MicrochipTech/EERAM-Curiosity-Demo/Docs/Media/EERAM-Curiosity-Demo.jpg

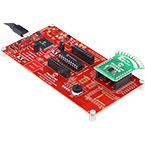
Docs/Media/EERAM-Curiosity-Demo.jpg
