MicrochipTech/EERAM-Curiosity-Demo/Docs/EERAM Curiosity Demo Bill of Materials.xls

Sheet: BOM Report
Bill of Materials |  | EERAM DEMO FOR FIELD APPS
Document Number: | 02-EERAM_DEMO_FAE_1.00 |  |  |  |  | M
Board Number: | 04-EERAM_DEMO_FAE_1.00
Part Number: | 47L64
Revision: | 1.00
Engineer: | Dragos Ciofu
Drawn By: | Dragos Ciofu
Creation Date: | 7:39:08 PM
Print Date: | 19:40:01
Quantity | Designator | Description_ | Manufacturer 1 | Manufacturer Part Number 1 | Supplier 1 | Supplier Part Number 1 | Supplier Unit Price 1 | Price / 1 Board | Populated | Quantity | Quantity Override | Status | MCHP-ID
1 | C1 | CAP CER 22uF 10V 20% X5R SMD 1206 | Taiyo Yuden (https://octopart-clicks.com/click/altium?sku=587-1343-1-ND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) | LMK316BJ226ML-T (https://octopart-clicks.com/click/altium?sku=587-1343-1-ND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) | Digi-Key | 587-1343-1-ND (https://octopart-clicks.com/click/altium?sku=587-1343-1-ND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) |  | $0.0000 | Yes | 1 | 1 | MCL Design | CAP0563
1 | C3 | CAP CER 0.1uF 16V 10% X7R SMD 0603 | AVX (https://octopart-clicks.com/click/altium?sku=478-1239-1-ND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) | 0603YC104KAT2A (https://octopart-clicks.com/click/altium?sku=478-1239-1-ND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) | Digi-Key | 478-1239-1-ND (https://octopart-clicks.com/click/altium?sku=478-1239-1-ND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) |  | $0.0000 | YES | 1 | 1 | Production | CAP0011
1 | C4 | CAP CER 4.7uF 10V 80% Y5V SMD 0603 | Murata (https://octopart-clicks.com/click/altium?sku=490-3302-1-ND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) | GRM188F51A475ZE20D (https://octopart-clicks.com/click/altium?sku=490-3302-1-ND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) | Digi-Key | 490-3302-1-ND (https://octopart-clicks.com/click/altium?sku=490-3302-1-ND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) |  | $0.0000 | YES | 1 | 1 | Production | CAP0384
2 | JM1, JM2 | CON HDR-2.54 Male 1x8 Gold 5.84MH TH | FCI (https://octopart-clicks.com/click/altium?sku=609-3273-ND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) | 68001-108HLF (https://octopart-clicks.com/click/altium?sku=609-3273-ND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) | Digi-Key | 609-3273-ND (https://octopart-clicks.com/click/altium?sku=609-3273-ND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) |  | $0.0000 | YES | 2 | 1 | Production | CON1302
1 | LABEL1 | LABEL, NEED HELP WITH ASSY/SERIAL |  |  |  |  |  | $0.0000 | MECH | 1 | 1 | MCL Design | 08-00126
1 | LABEL2 | LABEL, ASSY W/REV LEVEL (SMALL MODULES) PER MTS-0002 |  |  |  |  |  | $0.0000 | MECH | 1 | 1 | MCL Design | 08-00028
1 | LABEL3 | Label, AIPD Board Assembly |  |  |  |  |  | $0.0000 | MECH | 1 | 1 | MCL Design | 08-00004
13 | LD0, LD1, LD2, LD3, LD4, LD5, LD6, LD7, LD8, LD9, LD10, LD11, LP | DIO LED GREEN 2V 30mA 44.5mcd Clear SMD 1206 | Lite-On Inc (https://octopart-clicks.com/click/altium?sku=160-1404-1-ND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) | LTST-C150KGKT (https://octopart-clicks.com/click/altium?sku=160-1404-1-ND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) | Digi-Key | 160-1404-1-ND (https://octopart-clicks.com/click/altium?sku=160-1404-1-ND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) |  | $0.0000 | YES | 13 | 1 | MCL Design | DIODE1020
1 | LR | DIO LED RED 1.7V 20mA 51mcd Clear SMD 1206 | Visual Communications Company (https://octopart-clicks.com/click/altium?manufacturer=Visual%20Communications%20Company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) | CMD11-21SRC/TR8 (https://octopart-clicks.com/click/altium?manufacturer=Visual%20Communications%20Company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) | Digi-Key | L62011CT-ND (https://octopart-clicks.com/click/altium?manufacturer=Visual%20Communications%20Company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) |  | $0.0000 | Yes | 1 | 1 | MCL Design | LED0094
7 | R1, RL0, RL1, RL2, RL3, RLP, RLR | RES TKF 82R 1% 1/4W SMD 0603 | Vishay (https://octopart-clicks.com/click/altium?sku=CRCW060382R0FKEAHP-ND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) | CRCW060382R0FKEAHP (https://octopart-clicks.com/click/altium?sku=CRCW060382R0FKEAHP-ND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) | Digi-Key | CRCW060382R0FKEAHP-ND (https://octopart-clicks.com/click/altium?sku=CRCW060382R0FKEAHP-ND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) |  | $0.0000 | Yes | 7 | 1 | Production | RES1211
2 | RP1, RP2 | RES TKF 2k 1% 1/10W SMD 0603 | Panasonic (https://octopart-clicks.com/click/altium?sku=P2.00KHTR-ND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) | ERJ-3EKF2001V (https://octopart-clicks.com/click/altium?sku=P2.00KHTR-ND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) | Digi-Key | P2.00KHTR-ND (https://octopart-clicks.com/click/altium?sku=P2.00KHTR-ND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) |  | $0.0000 | YES | 2 | 1 | Production | RSMT0382
1 | U1 |  |  |  |  |  |  | $0.0000 |  | 1
Microchip Parts listed below
 |  |  |  |  |  |  |  | $0.0000
 |  |  |  |  |  |  |  | $0.0000
 |  |  |  |  |  |  |  | $0.0000
 |  |  |  |  |  |  |  | $0.0000
Mechanical Parts to be added in the package
 |  |  |  |  |  |  |  | $0.0000
PCB
1 | PCB1 | Printed Circuit Board |  | 04-EERAM_DEMO_FAE_1.00-R1.00 |  |  |  | $0.0000 | PCB | 1 | 1 |  | 04-EERAM_DEMO_FAE_1.00
 |  |  |  |  |  |  |  | $0.0000
Do Not Populate Parts listed below
 |  |  |  |  |  |  |  | $0.0000
Approved | Notes | Description

Sheet: Project Information
Project Full Path | C:\ALTIUM_WORK\Projects\I2C DEMO ALTIUM 18\I2C DEMO ALTIUM 18.PrjPcb
Project Filename | I2C DEMO ALTIUM 18.PrjPcb
Variant Name | None
Board Number | EERAM_DEMO_FAE_1.00
Data-Source Filename | I2C DEMO ALTIUM 18.PrjPcb
Data-Source Full Path | C:\ALTIUM_WORK\Projects\I2C DEMO ALTIUM 18\I2C DEMO ALTIUM 18.PrjPcb
Title | EERAM DEMO FOR FIELD APPS
Total Quantity | 32
Report Time | 7:39:08 PM
Report Date | 7/9/2018
Report Date & Tine | 7/9/2018 7:39:08 PM
Output Name | Bill of Materials
Output Type | BOM_PartType
Output Generator Name | BOM
Output Generator Description | Bill of Materials
PCB Label Number | <Parameter ProjectBoardLabel not found>
Part Number | 47L64
SCH Revision | 1.00
ART Revision | 1.00
ASM Revision | 1.00
FAB Revision | 1.00

Sheet: MCL Report
DesignItemId | Quantity | Designator | Populated | Fitted | Description_ | Value | Status | Library Name | PartType | Footprint | MCL Library Ref | MCL Footprint Ref | CurrentDate | Manufacturer 1 | Manufacturer 2 | Manufacturer 3 | Manufacturer 4 | Manufacturer 5 | Manufacturer 6 | Manufacturer 7 | #Column Name Error:Manufacturer 8 | #Column Name Error:Manufacturer 9 | #Column Name Error:Manufacturer 10 | Manufacturer Part Number 1 | Manufacturer Part Number 2 | Manufacturer Part Number 3 | Manufacturer Part Number 4 | Manufacturer Part Number 5 | Manufacturer Part Number 6 | Manufacturer Part Number 7 | #Column Name Error:Manufacturer Part Number 8 | #Column Name Error:Manufacturer Part Number 9 | #Column Name Error:Manufacturer Part Number 10 | Supplier 1 | Supplier 2 | Supplier 3 | Supplier 4 | Supplier 5 | Supplier 6 | Supplier 7 | #Column Name Error:Supplier 8 | #Column Name Error:Supplier 9 | #Column Name Error:Supplier 10 | Supplier Part Number 1 | Supplier Part Number 2 | Supplier Part Number 3 | Supplier Part Number 4 | Supplier Part Number 5 | Supplier Part Number 6 | Supplier Part Number 7 | #Column Name Error:Supplier Part Number 8 | #Column Name Error:Supplier Part Number 9 | #Column Name Error:Supplier Part Number 10 | Supplier Unit Price 1 | Supplier Unit Price 2 | Supplier Unit Price 3 | Supplier Unit Price 4 | Supplier Unit Price 5 | Supplier Unit Price 6
CAP0563 | 1 | C1 | Yes | Fitted | CAP CER 22uF 10V 20% X5R SMD 1206 | 22uF | MCL Design | MCHP-CDB.DbLib | Capacitor NP | CAP_C_1206 |  |  | 7/9/2018 | Taiyo Yuden (https://octopart-clicks.com/click/altium?sku=587-1343-1-ND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) |  |  |  |  |  |  |  |  |  | LMK316BJ226ML-T (https://octopart-clicks.com/click/altium?sku=587-1343-1-ND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) |  |  |  |  |  |  |  |  |  | Digi-Key |  |  |  |  |  |  |  |  |  | 587-1343-1-ND (https://octopart-clicks.com/click/altium?sku=587-1343-1-ND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)
CAP0011 | 1 | C3 | YES | Fitted | CAP CER 0.1uF 16V 10% X7R SMD 0603 | 0.1uF | Production | MCHP-CDB-Offline.DbLib | Capacitor NP | CAP_C_0603 |  |  | 7/9/2018 | AVX (https://octopart-clicks.com/click/altium?sku=478-1239-1-ND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) | Murata (https://octopart-clicks.com/click/altium?sku=490-1532-1-ND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) | Panasonic (https://octopart-clicks.com/click/altium?sku=PCC1762CT-ND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) | Taiyo Yuden (https://octopart-clicks.com/click/altium?sku=587-1240-2-ND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) | Yageo (https://octopart-clicks.com/click/altium?sku=86H5248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) | NIC Components (https://octopart-clicks.com/click/altium?manufacturer=NIC%20Components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) |  |  |  |  | 0603YC104KAT2A (https://octopart-clicks.com/click/altium?sku=478-1239-1-ND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) | GRM188R71C104KA01D (https://octopart-clicks.com/click/altium?sku=490-1532-1-ND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) | ECJ-1VB1C104K (https://octopart-clicks.com/click/altium?sku=PCC1762CT-ND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) | EMK107B7104KA-T (https://octopart-clicks.com/click/altium?sku=587-1240-2-ND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) | CC0603KRX7R7BB104 (https://octopart-clicks.com/click/altium?sku=86H5248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) | NMC0603X7R104K16TRPF (https://octopart-clicks.com/click/altium?manufacturer=NIC%20Components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) |  |  |  |  | Digi-Key | Digi-Key | Digi-Key | Digi-Key | Newark | Digi-Key | NIC Components |  |  |  | 478-1239-1-ND (https://octopart-clicks.com/click/altium?sku=478-1239-1-ND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) | 490-1532-1-ND (https://octopart-clicks.com/click/altium?sku=490-1532-1-ND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) | PCC1762CT-ND (https://octopart-clicks.com/click/altium?sku=PCC1762CT-ND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) | 587-1240-2-ND (https://octopart-clicks.com/click/altium?sku=587-1240-2-ND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) | 86H5248 (https://octopart-clicks.com/click/altium?sku=86H5248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) | 311-1088-1-ND (https://octopart-clicks.com/click/altium?manufacturer=NIC%20Components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) | NMC0603X7R104K16TRPF
CAP0384 | 1 | C4 | YES | Fitted | CAP CER 4.7uF 10V 80% Y5V SMD 0603 | 4.7uF | Production | MCHP-CDB-Offline.DbLib | Capacitor NP | CAP_C_0603 |  |  | 7/9/2018 | Murata (https://octopart-clicks.com/click/altium?sku=490-3302-1-ND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) | Taiyo Yuden (https://octopart-clicks.com/click/altium?sku=587-1785-1-nd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) |  |  |  |  |  |  |  |  | GRM188F51A475ZE20D (https://octopart-clicks.com/click/altium?sku=490-3302-1-ND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) | JMK107BJ475KA-T (https://octopart-clicks.com/click/altium?sku=587-1785-1-nd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) |  |  |  |  |  |  |  |  | Digi-Key | Digi-Key |  |  |  |  |  |  |  |  | 490-3302-1-ND (https://octopart-clicks.com/click/altium?sku=490-3302-1-ND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) | 587-1785-1-nd (https://octopart-clicks.com/click/altium?sku=587-1785-1-nd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)
CON1302 | 2 | JM1, JM2 | YES | Fitted | CON HDR-2.54 Male 1x8 Gold 5.84MH TH | 2 x HDR-2.54 Male 1x8, [NoParam] | Production | MCHP-CDB-Offline.DbLib | Header 1x8 | HDR_M_2.54_1x8 |  |  | 7/9/2018 | FCI (https://octopart-clicks.com/click/altium?sku=609-3273-ND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) |  |  |  |  |  |  |  |  |  | 68001-108HLF (https://octopart-clicks.com/click/altium?sku=609-3273-ND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) |  |  |  |  |  |  |  |  |  | Digi-Key |  |  |  |  |  |  |  |  |  | 609-3273-ND (https://octopart-clicks.com/click/altium?sku=609-3273-ND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)
08-00126 | 1 | LABEL1 | MECH | Fitted | LABEL, NEED HELP WITH ASSY/SERIAL | Label Need Help Large | MCL Design | MCHP-CDB.DbLib | LABEL_Need_Help_Large | LABEL_Need_Help_Large |  |  | 7/9/2018
08-00028 | 1 | LABEL2 | MECH | Fitted | LABEL, ASSY W/REV LEVEL (SMALL MODULES) PER MTS-0002 | LABEL Need Help Small | MCL Design | MCHP-CDB.DbLib | LABEL_Need_Help_Small | LABEL_Need_Help_Small |  |  | 7/9/2018
08-00004 | 1 | LABEL3 | MECH | Fitted | Label, AIPD Board Assembly | LABEL Assy Very Small | MCL Design | MCHP-CDB.DbLib | LABEL_Assy_Very_Small | LABEL_Assy_Very_Small |  |  | 7/9/2018
DIODE1020 | 13 | LD0, LD1, LD2, LD3, LD4, LD5, LD6, LD7, LD8, LD9, LD10, LD11, LP | YES | Fitted | DIO LED GREEN 2V 30mA 44.5mcd Clear SMD 1206 | GREEN | MCL Design | MCHP-CDB.DbLib | LED_green | LED_1206_Green |  |  | 7/9/2018 | Lite-On Inc (https://octopart-clicks.com/click/altium?sku=160-1404-1-ND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) |  |  |  |  |  |  |  |  |  | LTST-C150KGKT (https://octopart-clicks.com/click/altium?sku=160-1404-1-ND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) |  |  |  |  |  |  |  |  |  | Digi-Key |  |  |  |  |  |  |  |  |  | 160-1404-1-ND (https://octopart-clicks.com/click/altium?sku=160-1404-1-ND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)
LED0094 | 1 | LR | Yes | Fitted | DIO LED RED 1.7V 20mA 51mcd Clear SMD 1206 | RED | MCL Design | MCHP-CDB.DbLib | LED_red | LED_1206_Red |  |  | 7/9/2018 | Visual Communications Company (https://octopart-clicks.com/click/altium?manufacturer=Visual%20Communications%20Company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) |  |  |  |  |  |  |  |  |  | CMD11-21SRC/TR8 (https://octopart-clicks.com/click/altium?manufacturer=Visual%20Communications%20Company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) |  |  |  |  |  |  |  |  |  | Digi-Key |  |  |  |  |  |  |  |  |  | L62011CT-ND (https://octopart-clicks.com/click/altium?manufacturer=Visual%20Communications%20Company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)
RES1211 | 7 | R1, RL0, RL1, RL2, RL3, RLP, RLR | Yes | Fitted | RES TKF 82R 1% 1/4W SMD 0603 | 82R, 100R | Production | MCHP-CDB-Offline.DbLib | Resistor | RES_C_0603 |  |  | 7/9/2018 | Vishay (https://octopart-clicks.com/click/altium?sku=CRCW060382R0FKEAHP-ND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) |  |  |  |  |  |  |  |  |  | CRCW060382R0FKEAHP (https://octopart-clicks.com/click/altium?sku=CRCW060382R0FKEAHP-ND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) |  |  |  |  |  |  |  |  |  | Digi-Key | Farnell |  |  |  |  |  |  |  |  | CRCW060382R0FKEAHP-ND (https://octopart-clicks.com/click/altium?sku=CRCW060382R0FKEAHP-ND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) | 1738890
RSMT0382 | 2 | RP1, RP2 | YES | Fitted | RES TKF 2k 1% 1/10W SMD 0603 | 2k | Production | MCHP-CDB-Offline.DbLib | Resistor | RES_C_0603 |  |  | 7/9/2018 | Panasonic (https://octopart-clicks.com/click/altium?sku=P2.00KHTR-ND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) |  |  |  |  |  |  |  |  |  | ERJ-3EKF2001V (https://octopart-clicks.com/click/altium?sku=P2.00KHTR-ND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) |  |  |  |  |  |  |  |  |  | Digi-Key | Digi-Key |  |  |  |  |  |  |  |  | P2.00KHTR-ND (https://octopart-clicks.com/click/altium?sku=P2.00KHTR-ND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) | P2.00KHCT-ND
eeram_spi | 1 | U1 |  | Fitted |  |  |  | eeram_i2c.SchLib | eeram_spi | SOIC-8 |  |  | 7/9/2018
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
