MicrochipTech/EERAM-Curiosity-Demo/Docs/EERAM Curiosity Demo Schematic.PDF

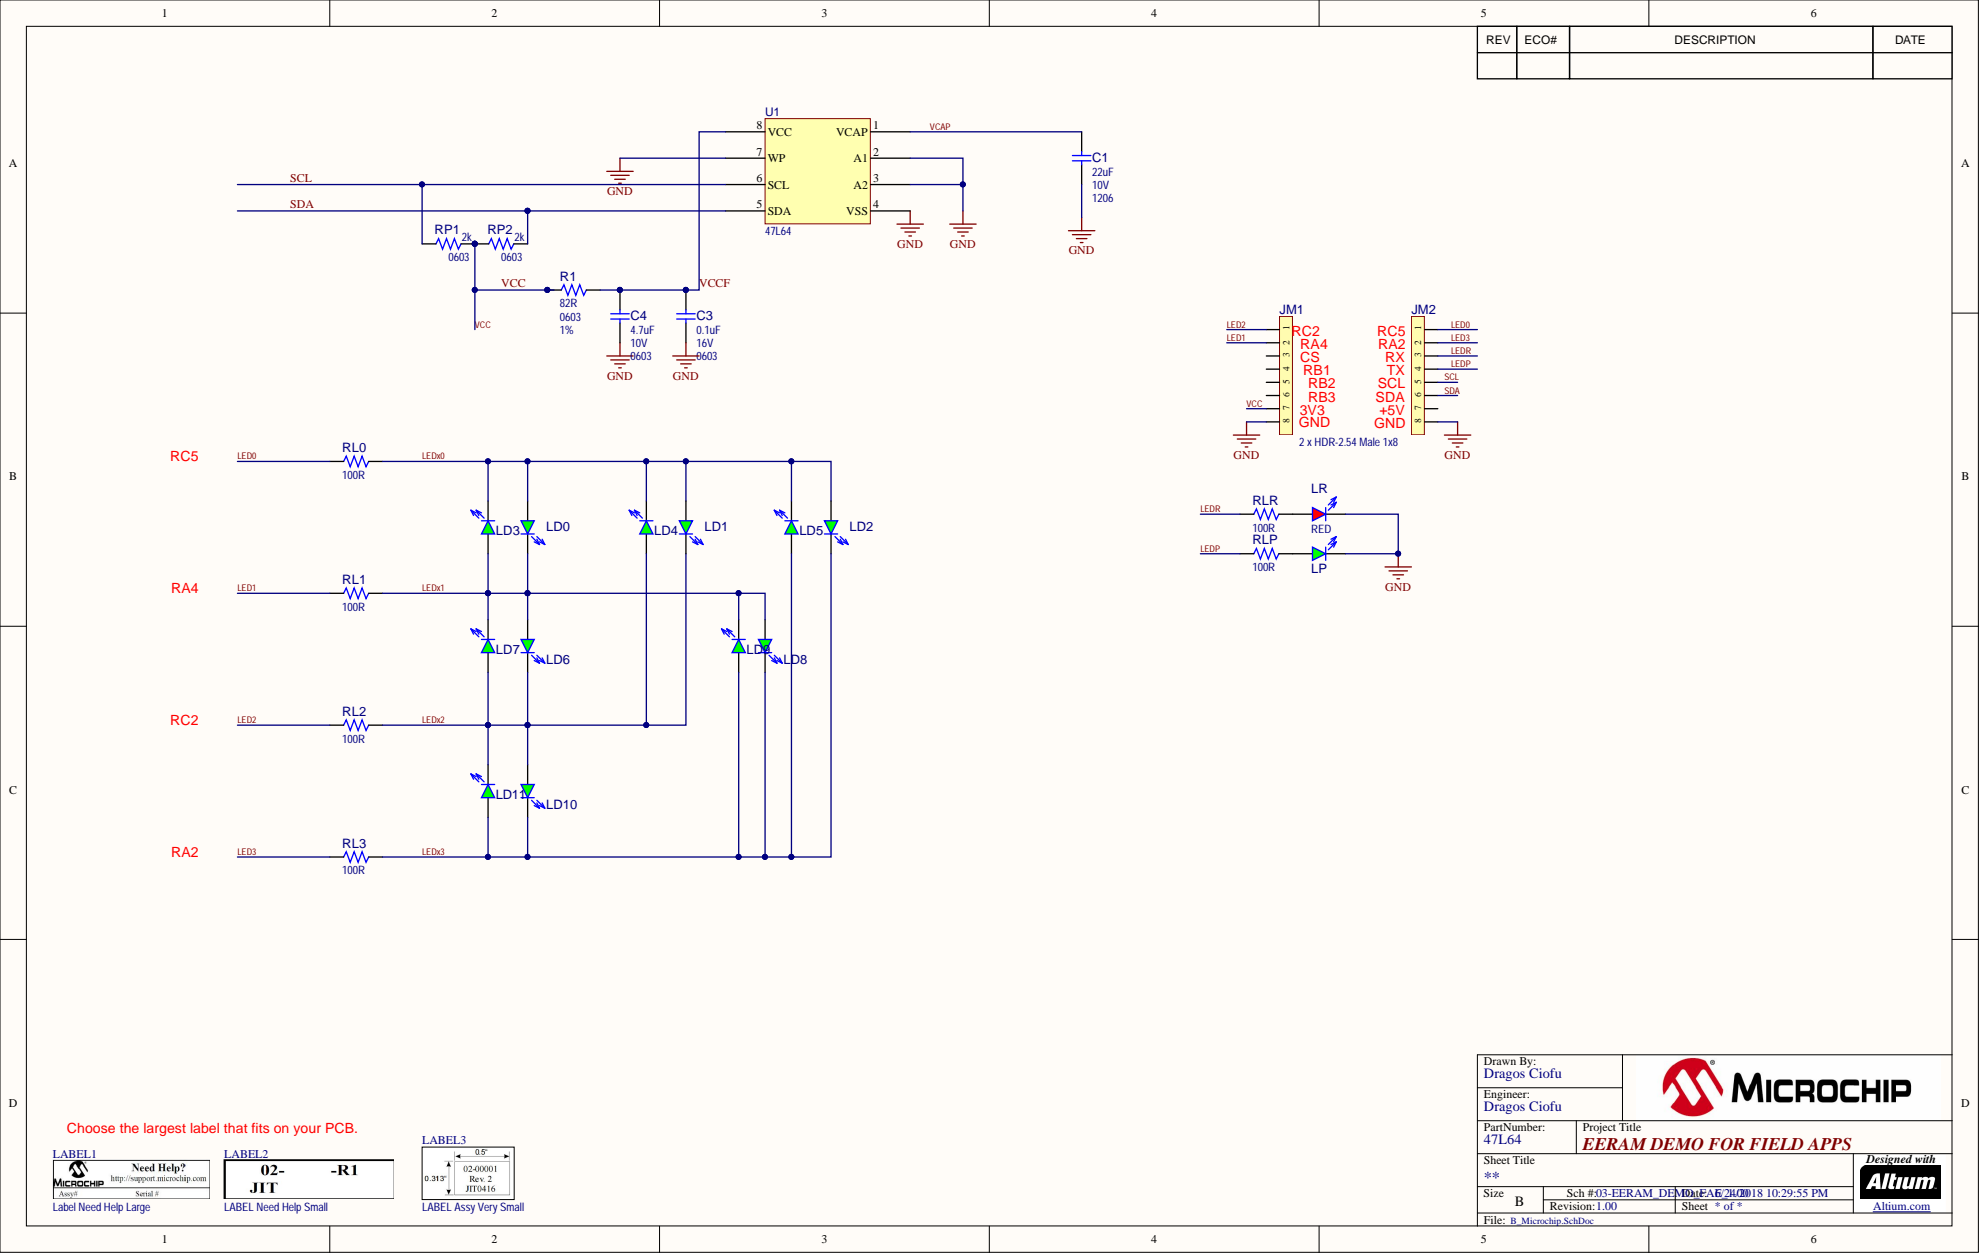
[picture p5: page 1]

Choose the largest label that fits on your PCB.

Project Title
EERAM DEMO FOR FIELD APPS

Sheet Title ** | Designed with Altium.com

Size B | Sch #: 03-EERAM_DEMO_FAE_1.00 | Date: 6/24/2018 10:29:55 PM

Label Need Help Large

LABEL Need Help Small

LABEL Assy Very Small

Revision: 1.00 | Sheet * of *
